Dingzhenzz/stm32-smart-parking-car/docs/模式参数对照表.md

# 模式参数对照表

本文档记录当前两种寻位/入位模式、两种车位类型下的标定参数，并与 `firmware/Core/Src/main.c` 中的宏保持一致。

## 1. 符号说明

| 符号 | 含义 |
|---|---|
| `L_open` | 搜索阶段按 `18.46 × t_open` 估算的开口长度（沿行驶方向） |
| `L_depth` | 开放区内的最大侧向净距，即车位深度 |
| `raw_at_stop` | 识别到车位并停车时的原始超声距离 |
| `R2F` | 后往前寻位 + 倒车入位 |
| `F2R` | 前往后寻位 + 前进入位 |

注意：垂直模式下 `L_open` 是**开口长度**（约 22–37 cm），不是 40 cm 的槽深；槽深使用 `L_depth`。

## 2. 实测基准

- 直线速度：`18.46 cm/s`（10% 占空比）
- 自转速度：`15%` 占空比
- 自转参考：一圈约 `6.1 s`（早期粗略参考，不用于精确反算角度）
- 标定日期：`2026-03-19`

补充标定备注：

- `2026-03-20` 已确认“垂直车位 + 后往前寻位 + 倒车入位”参数可稳定使用。
- `2026-03-20` 已补齐“垂直车位 + 前往后寻位 + 前进入位”代码链路，当前参数仍在精调。
- `2026-03-21` 对垂直自转时间做了修正，具体以表中经验值为准。

## 3. 侧方位车位

| 模式 | 寻位/停车方向 | 第一段直行 `d1` | 第一次自转 | 第二段直行 `d2` | 第二次自转 | 状态 |
|---|---|---|---|---|---|---|
| `R2F search + reverse park` | 后往前寻位，倒车入库 | `4 × L_open / 5` | `1301 ms` | `1.1 × raw_at_stop` | `1544 ms` | 已稳定 |
| `F2R search + forward park` | 前往后寻位，前进入库 | `L_open / 2` | `1464 ms` | `1.1 × raw_at_stop` | `1563 ms` | 已稳定 |

## 4. 垂直车位

| 车位类型 | 模式 | 第一段直行 `d1` | 第一次自转 | 第二段直行 `d2` | 状态 |
|---|---|---|---|---|---|
| 垂直车位 | 后往前寻位 + 倒车入位 | `9 × L_open / 10` | `1303 ms` | `L_depth − 6 cm` | 已可用，继续微调 |
| 垂直车位 | 前往后寻位 + 前进入位 | `3 × L_open / 4` | `1765 ms` | `min(L_depth − 18 cm, 40 cm)` | 已实现，继续精调 |

补充约束：

- 垂直对中距离有下限：`d1` 不小于 `8 cm`，且不大于 `L_open`
- 垂直前进入位的 `d2` 上限为 `40 cm`
- 如果计算出的 `d2 < 车长 / 2`，`Parking_Start()` 会直接中止

## 5. 车位识别边界与优先级

- 最小侧向开口：`22 cm`（`d_side > 22 cm` 才进入开放区）
- 最小侧方位长度：`37 cm`
- 垂直车位最小开口：`22 cm`
- 垂直车位最小槽深：`40 cm`

优先级：

1. 若 `L_open >= 37 cm`：判为侧方位车位
2. 否则若 `L_open >= 22 cm` 且 `L_depth >= 40 cm`：判为垂直车位
3. 否则继续搜索

因此，垂直车位只在开口长度未达到 37 cm 时才会被采用。

## 6. 通用参数

| 参数 | 数值 |
|---|---:|
| 车长 | `31.0 cm` |
| 车宽 | `17.0 cm` |
| 侧方位长度余量 | `6.0 cm` |
| 最小侧方位长度 | `37.0 cm` |
| 侧向开放区阈值 | `22.0 cm` |
| 侧方位时间阈值 | `37 / 18.46 ≈ 2.004 s` |
| 超声侧向偏移修正 | `9.0 cm` |
| 搜索速度 | `10%` |
| 泊车直行速度 | `10%` |
| 自转速度 | `15%` |

## 7. `main.c` 中对应的参数宏

平行模式：

- `PARK_TARGET1_RATIO_R2F`
- `PARK_TARGET1_RATIO_F2R`
- `T_FIRST_TURN_90_R2F_MS`
- `T_FIRST_TURN_90_F2R_MS`
- `T_SECOND_TURN_90_R2F_MS`
- `T_SECOND_TURN_90_F2R_MS`

垂直模式：

- `VERTICAL_ALIGN_RATIO_R2F`
- `VERTICAL_ALIGN_RATIO_F2R`
- `VERTICAL_ALIGN_MIN_CM`
- `VERTICAL_REVERSE_MARGIN_CM`
- `VERTICAL_FORWARD_MARGIN_CM`
- `VERTICAL_FORWARD_D2_MAX_CM`
- `T_VERTICAL_TURN_90_R2F_MS`
- `T_VERTICAL_TURN_90_F2R_MS`

搜索与安全：

- `SLOT_SENSOR_OFFSET_CM`
- `SLOT_WIDTH_THRESHOLD_CM`
- `SLOT_SEARCH_SPEED_CM_S`
- `SLOT_MIN_LENGTH_CM`
- `SLOT_TIME_THRESHOLD_S`
- `VERTICAL_SLOT_MIN_OPENING_CM`
- `VERTICAL_SLOT_MIN_DEPTH_CM`
- `D_SAFE_CM`
- `REVERSE_OBSTACLE_AVOID_ENABLE`
- `REVERSE_BEEP_ENABLE`

## 8. 关于“90°”和 6.1 s/圈

`T_FIRST_TURN_90_*`、`T_SECOND_TURN_90_*`、`T_VERTICAL_TURN_90_*` 中的 `90` 是设计目标，不是严格的角度闭环结果。

- 表中的自转时间来自实车标定，受电池电压、地面摩擦、电机一致性和车体负载影响。
- `6.1 s/圈` 只是早期粗略参考，不能用来精确反算每次自转的角度。
- 如果后续增加陀螺仪或编码器，应以实测角度重新标定，并同步更新本表和 `main.c`。

## 9. 更新说明

后续如果修改任一模式参数，请同步更新本文件、`docs/倒车算法实施.md` 和 `Core/Src/main.c`。
