Dingzhenzz/stm32-smart-parking-car/docs/images/esp8266-circuit.png

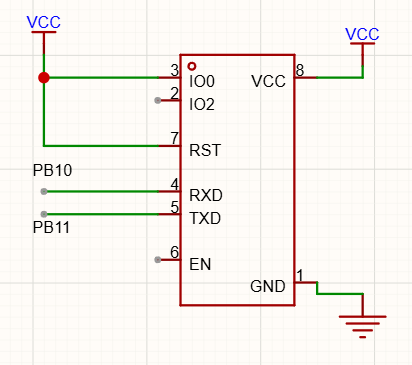
docs/images/esp8266-circuit.png
