Dingzhenzz/stm32-smart-parking-car/docs/images/motor-driver-circuit.png

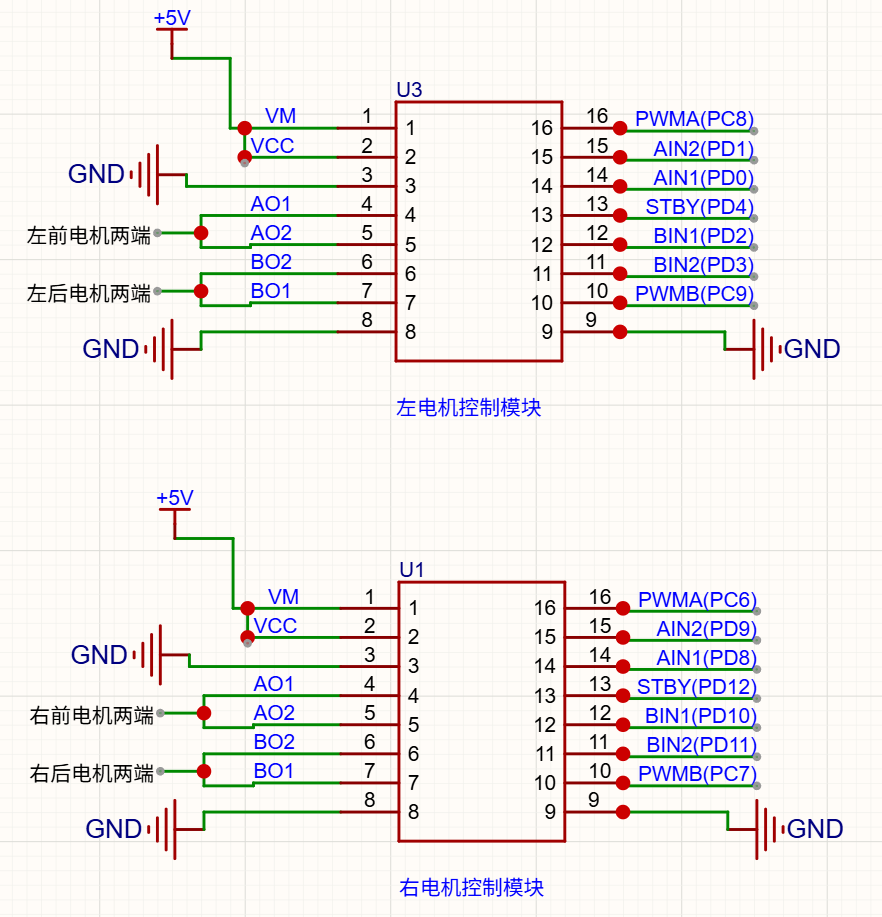
docs/images/motor-driver-circuit.png
