Dingzhenzz/stm32-smart-parking-car/docs/images/servo.png

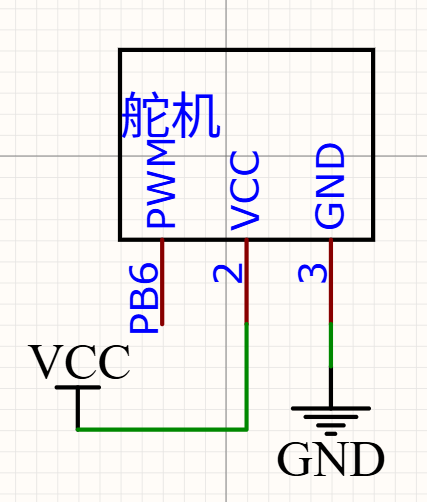
docs/images/servo.png
