Dingzhenzz/stm32-smart-parking-car/docs/images/sr04-circuit.png

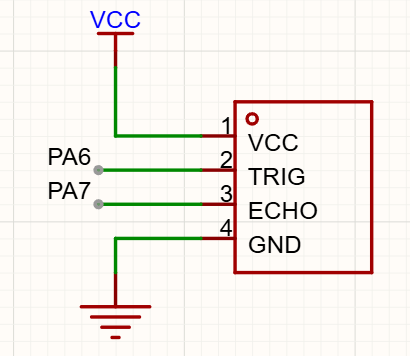
docs/images/sr04-circuit.png
