Dingzhenzz/stm32-smart-parking-car/firmware/Core/Inc/main.h

#define KEY2_Pin GPIO_PIN_2
#define KEY2_GPIO_Port GPIOE
#define KEY1_Pin GPIO_PIN_3
#define KEY1_GPIO_Port GPIOE
#define KEY0_Pin GPIO_PIN_4
#define KEY0_GPIO_Port GPIOE
#define KEY_UP_Pin GPIO_PIN_0
#define KEY_UP_GPIO_Port GPIOA
#define BEEP_Pin GPIO_PIN_8
#define BEEP_GPIO_Port GPIOF
#define MOTOR_RF_IN1_Pin GPIO_PIN_8
#define MOTOR_RF_IN1_GPIO_Port GPIOD
#define MOTOR_RF_IN2_Pin GPIO_PIN_9
#define MOTOR_RF_IN2_GPIO_Port GPIOD
#define MOTOR_RR_IN1_Pin GPIO_PIN_10
#define MOTOR_RR_IN1_GPIO_Port GPIOD
#define MOTOR_RR_IN2_Pin GPIO_PIN_11
#define MOTOR_RR_IN2_GPIO_Port GPIOD
#define MOTOR_RIGHT_STBY_Pin GPIO_PIN_12
#define MOTOR_RIGHT_STBY_GPIO_Port GPIOD
#define MOTOR_LF_IN1_Pin GPIO_PIN_0
#define MOTOR_LF_IN1_GPIO_Port GPIOD
#define MOTOR_LF_IN2_Pin GPIO_PIN_1
#define MOTOR_LF_IN2_GPIO_Port GPIOD
#define MOTOR_LR_IN1_Pin GPIO_PIN_2
#define MOTOR_LR_IN1_GPIO_Port GPIOD
#define MOTOR_LR_IN2_Pin GPIO_PIN_3
#define MOTOR_LR_IN2_GPIO_Port GPIOD
#define MOTOR_LEFT_STBY_Pin GPIO_PIN_4
#define MOTOR_LEFT_STBY_GPIO_Port GPIOD
