Dingzhenzz/stm32-smart-parking-car/(commit log)

2026-10-25 Initial commit: STM32F407 smart parking car
2026-11-02 Sync algorithm docs, add demo videos and ALIENTEK board notes
